SandwichRising/midiRouter/schematics/kicad/midiRouter.kicad_pcb

## KiCad design kicad/karatemeter/karatemeter.sch

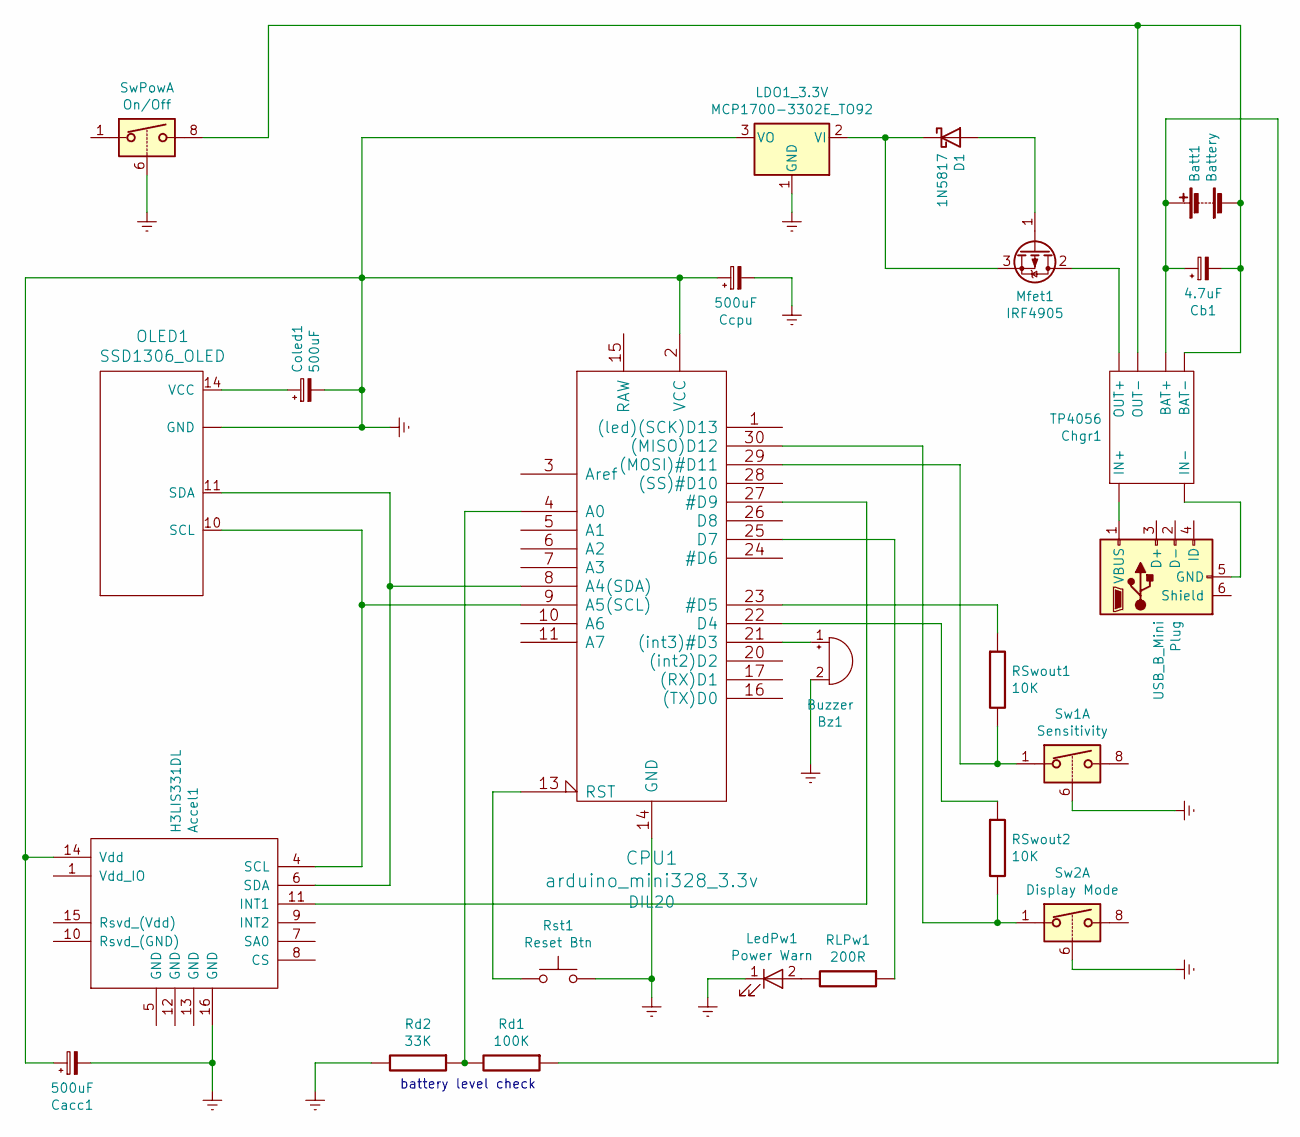
[picture p13: schematic karatemeter.sch]

Parts:
Accel1: H3LIS331DL; MODULE
Batt1: Battery
Bz1: Buzzer
CPU1: arduino_mini328_3.3v; DIL20
Cacc1: 500uF
Cb1: 4.7uF
Ccpu: 500uF
Chgr1: TP4056
Coled1: 500uF
D1: 1N5817; D_DO-41_SOD81_P10.16mm_Horizontal
LDO1_3.3V: MCP1700-3302E_TO92; TO-92_Inline
LedPw1: Power Warn
Mfet1: IRF4905; TO-220-3_Vertical
OLED1: SSD1306_OLED
Plug: USB_B_Mini
RLPw1: 200R
RSwout1, RSwout2: 10K
Rd1: 100K
Rd2: 33K
Rst1: Reset Btn
Sw1: Sensitivity; DIP-8_W7.62mm
Sw2: Display Mode; DIP-8_W7.62mm
SwPow: On/Off; DIP-8_W7.62mm

Connections:
Earth: Accel1.14 (Vdd), Accel1.16 (GND), Bz1.2 (+), CPU1.2 (VCC), CPU1.14 (GND), Cacc1.1, Cacc1.2, Ccpu.1, Ccpu.2, Coled1.2, LDO1_3.3V.1 (GND), LDO1_3.3V.3 (VO), LedPw1.1 (K), OLED1.~ (GND), Rd2.2, Rst1.2, Sw1.6, Sw2.6, SwPow.6
unnamed: Accel1.4 (SCL), CPU1.9 (A5(SCL)), OLED1.10 (SCL)
unnamed: Accel1.6 (SDA), CPU1.8 (A4(SDA)), OLED1.11 (SDA)
unnamed: Accel1.11 (INT1), CPU1.27 (#D9)
unnamed: Batt1.1 (+), Cb1.1, Chgr1.~, Rd1.1
unnamed: Batt1.2 (-), Cb1.2, Chgr1.~, SwPow.8
unnamed: Bz1.1 (-), CPU1.21 ((int3)#D3)
unnamed: CPU1.4 (A0), Rd1.2, Rd2.1
unnamed: CPU1.13 (RST), Rst1.1
unnamed: CPU1.22 (D4), RSwout2.1
unnamed: CPU1.23 (#D5), RSwout1.1
unnamed: CPU1.25 (D7), RLPw1.1
unnamed: CPU1.29 ((MOSI)#D11), RSwout1.2, Sw1.1
unnamed: CPU1.30 ((MISO)D12), RSwout2.2, Sw2.1
unnamed: Chgr1.~, Mfet1.2 (D), Plug.1 (VBUS), Plug.5 (GND)
unnamed: Coled1.1, OLED1.14 (VCC)
unnamed: D1.1 (K), LDO1_3.3V.2 (VI), Mfet1.3 (S)
unnamed: D1.2 (A), Mfet1.1 (G)
unnamed: LedPw1.2 (A), RLPw1.2

Notes on the sheet:
battery level check
