SandwichRising/midiRouter/(commit log)

2022-04-28 update midiRouter.ino
    Removed bug with DIN ports, was previously double transmitting out the tx/rx DIN pair automatically, and then again with software. Changed to suppress software transmit if message came in on TX/RX port pair.
    [midiRouter.ino]
2022-05-07 schematics update
    [midiRouter.kicad_pcb, midiRouter.sch, midi_inputs.sch, midi_outputs.sch]
2022-05-07 Update midiRouter_schematic_2.jpg
    corrected missing vusb label
    [midi_inputs.sch]
